hpoleselo/ufba_lab3/README.md

# Laboratório Integrado 3
Termometer Project + Reconstructing a signal with the aid of Fourier Series (MATLAB).
Work from Henrique Poleselo and Rodrigo Canário

EDIT README
