hpoleselo/ufba_lab3/images/ampop_inversora.png

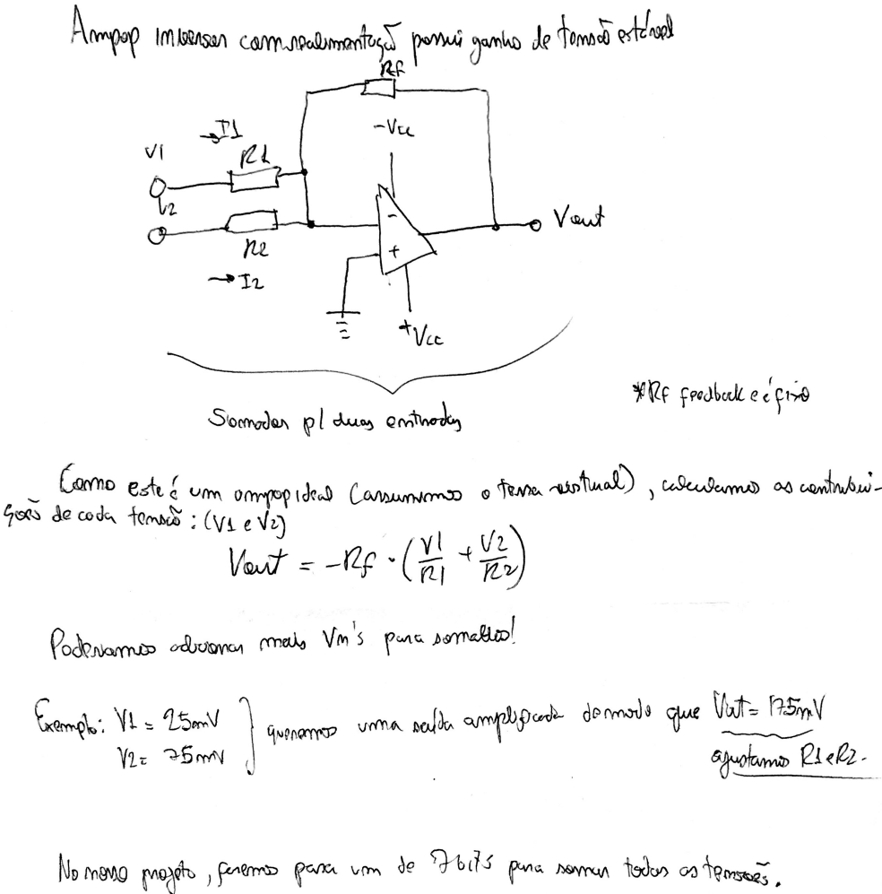
images/ampop_inversora.png
