hpoleselo/ufba_lab3/images/levantamento_curva.png

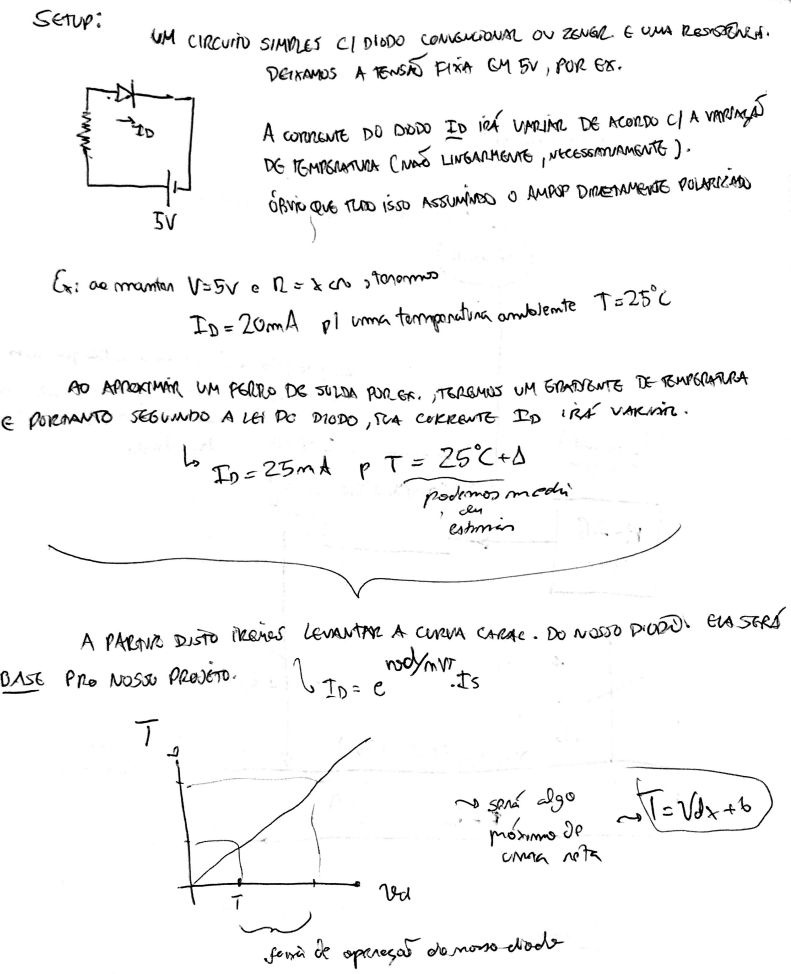
images/levantamento_curva.png
