hpoleselo/ufba_lab3/Termometro/guia/PassandoPraPlaca.png

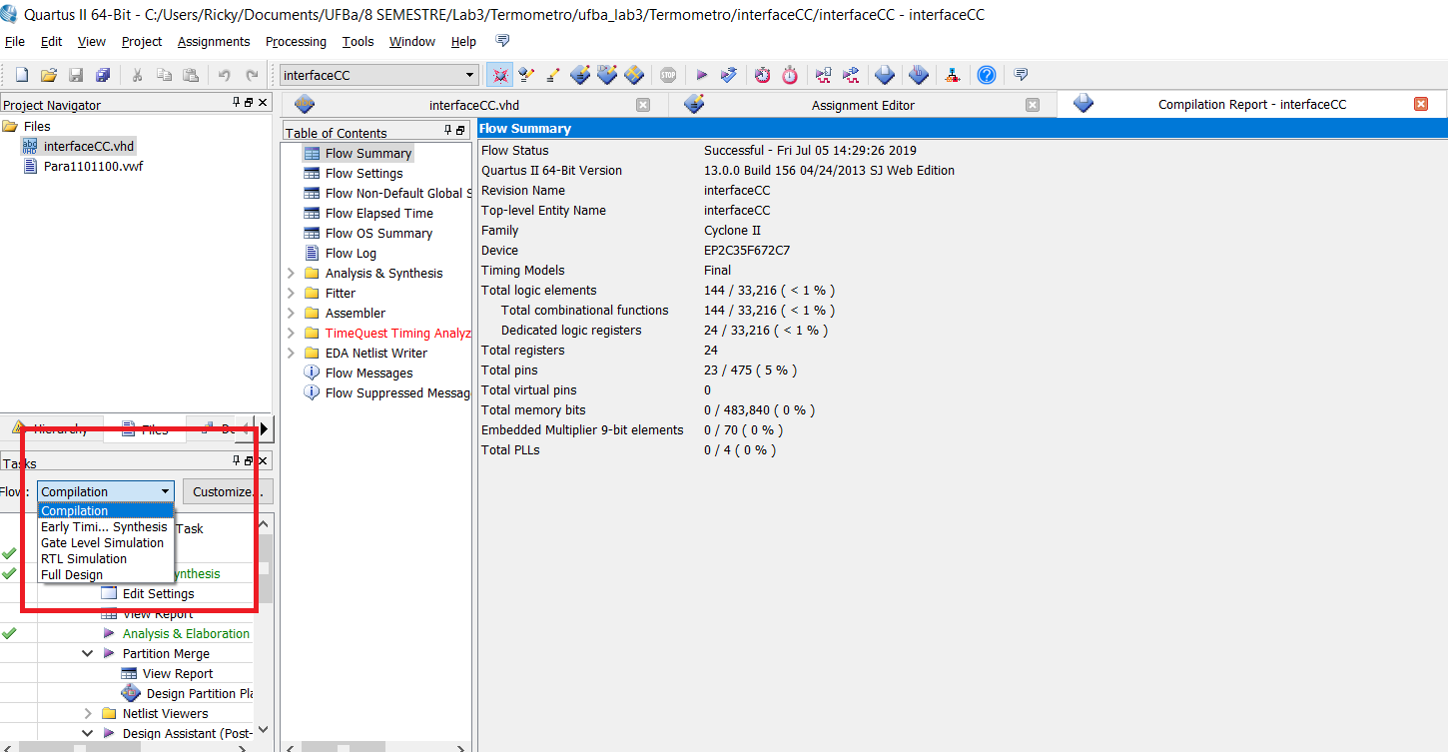
Termometro/guia/PassandoPraPlaca.png
