hpoleselo/ufba_lab3/Termometro/guia/Pinagem.png

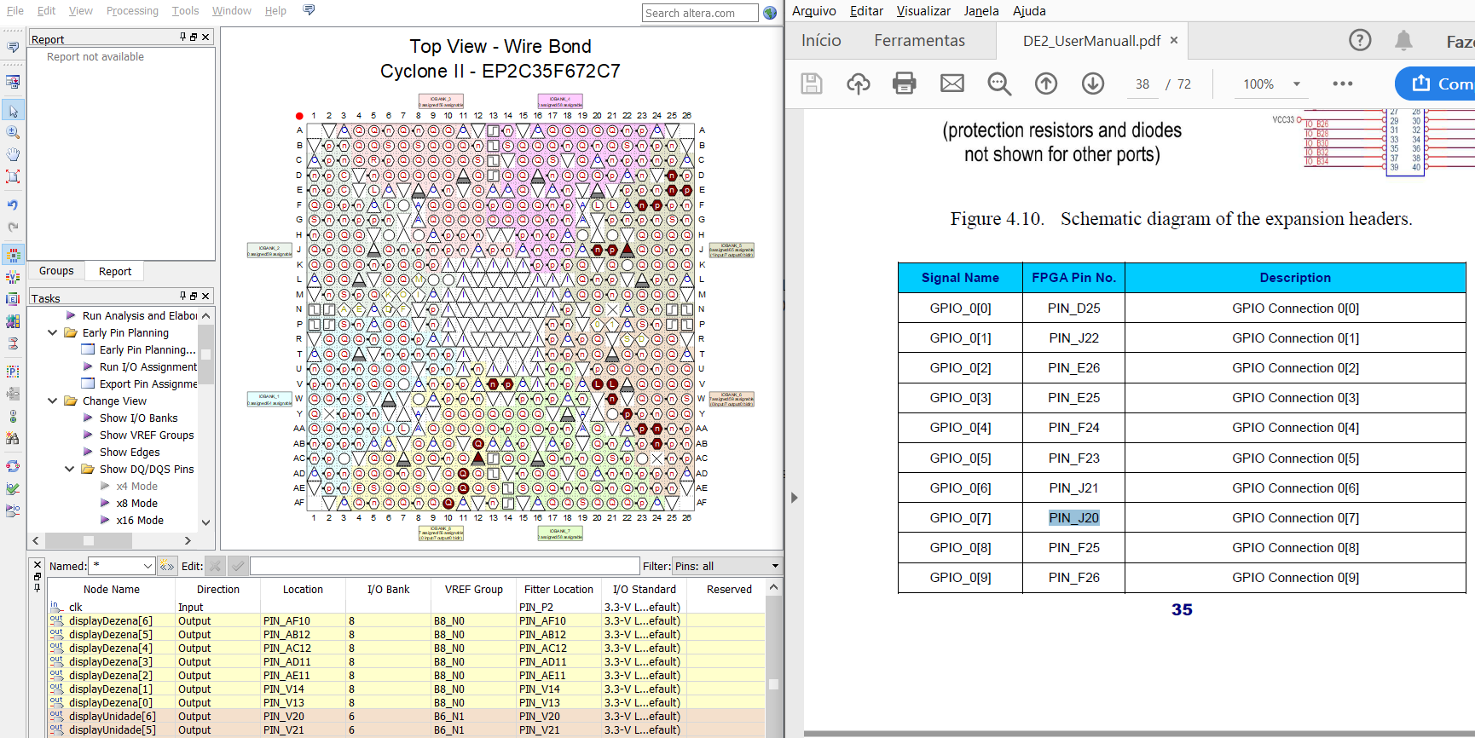
Termometro/guia/Pinagem.png
