hpoleselo/ufba_lab3/Termometro/interfaceCC/1001001Simulation.png

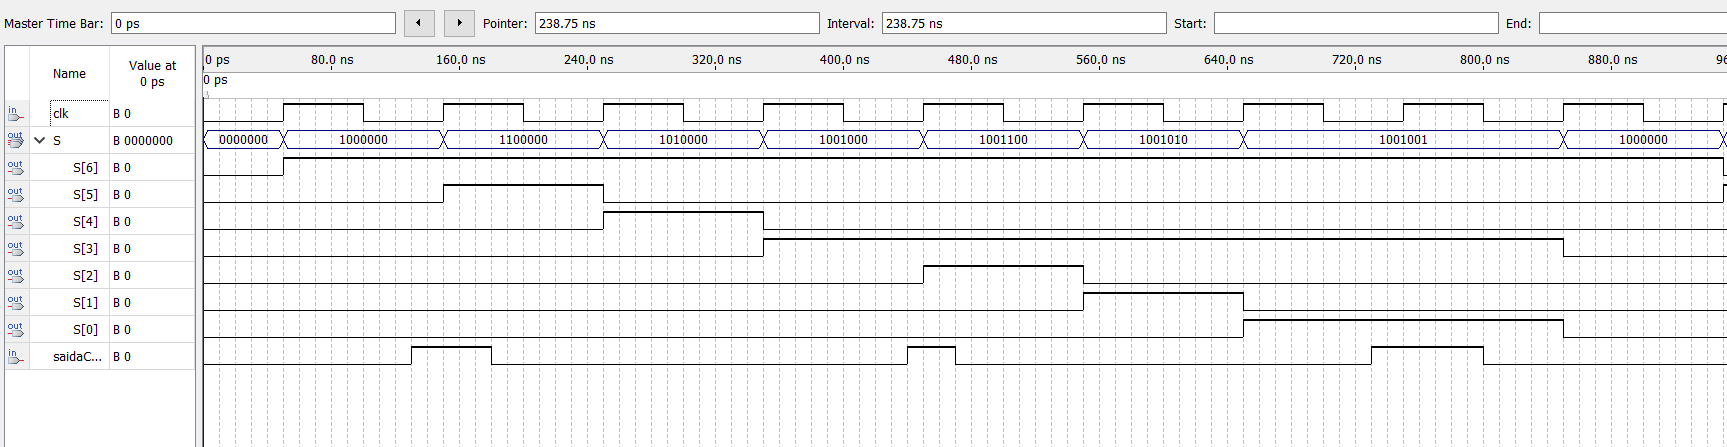
Termometro/interfaceCC/1001001Simulation.png
