hpoleselo/ufba_lab3/(list of files, cad)

Other CAD files:
Termometro/interfaceCC/simulation/qsim/work/interface@c@c/verilog.psm
Termometro/interfaceCC/simulation/qsim/work/interface@c@c_vlg_check_tst/verilog.psm
Termometro/interfaceCC/simulation/qsim/work/interface@c@c_vlg_sample_tst/verilog.psm
Termometro/interfaceCC/simulation/qsim/work/interface@c@c_vlg_vec_tst/verilog.psm
