hpoleselo/ufba_lab3/(list of files, drawings)

Other design files:
Termometro/Comparador.ms14
Termometro/Condicionamento.ms14
Termometro/dac4bits.ms14
Termometro/dac8bits.ms14
Termometro/Dac_Original.ms14
Termometro/FonteSimetrica_Original.ms14
Termometro/SensorCircuit.ms14
