hpoleselo/ufba_lab3/images/thermosensorsetup.jpg

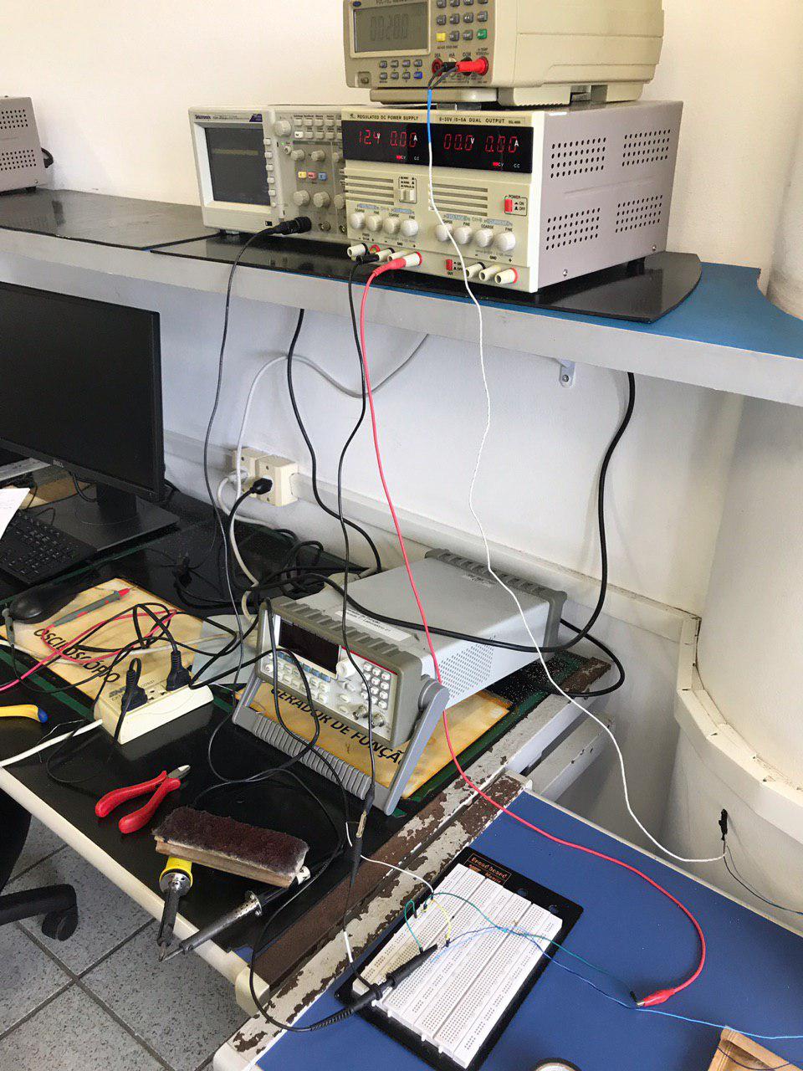
images/thermosensorsetup.jpg
