hpoleselo/ufba_lab3/(commit log)

2019-03-31 Added another folder for the termometer
    [dac4bits.ms14, dac8bits.ms14]
2019-04-12 Images and commentaries wrt. ADC added
2019-04-17 R2R and Diode Curve Circuit simulations
    Added the circuit for the R2R network simulation and the Diode curve circuit
    [Dac_Original.ms14, SensorCircuit.ms14]
2019-04-19 Create CurvaCarac.xlsx
    curva caracteristica parcial
    [CurvaCarac.xlsx]
2019-04-20 Create FonteSimetrica.ms14
    Sketch da fonte simetrica
    [FonteSimetrica.ms14]
2019-05-28 condicionamento
    circuito de condicionamento
    [Condicionamento.ms14, FonteSimetrica.ms14]
2019-07-02 Comparator+Cond VHDL Code
    Comparator+Cond VHDL Code
    [Comparador.ms14, Condicionamento.ms14, Dac_Original.ms14, verilog.psm]
2019-07-07 interface updated
    interface updated
    [verilog.psm]
